MakeICT/MCP-Client/README.md

# MCP-Client
Clients for the Master Control Program

Code compiled using ESP-IDF v3.3. Installation instructions can be found here: https://docs.espressif.com/projects/esp-idf/en/stable/get-started/index.html#introduction
