MakeICT/MCP-Client/hardware/Reader 3.0.brd

## EAGLE design hardware/Reader 3.0.brd (2019-04-20)

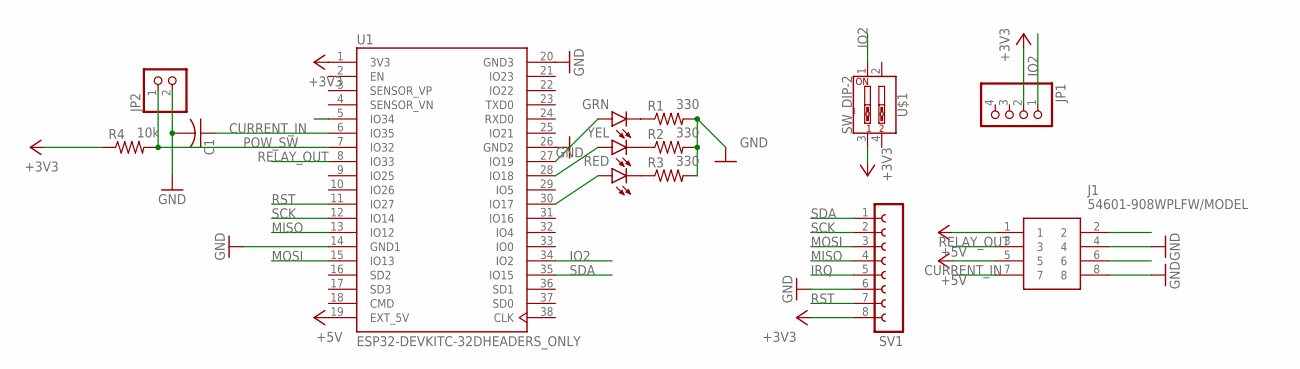
[picture p1: schematic Reader 3.0.sch]

Parts:
C1: C-US025-025X050; C025-025X050
GRN: LED5MM
J1: 54601-908WPLFW/MODEL; HDRV4W64P254_1X4_1016X508X838B
JP1: PINHD-1X4/90; 1X04/90
JP2: PINHD-1X2/90; 1X02/90
R1, R2, R3: 330; 0204/7
R4: 10k; 0204/7
RED: LED5MM
SV1: FE08-1; HDR_F_1X8
U1: ESP32-DEVKITC-32DHEADERS_ONLY; ESP32_DEVKITC_DIP
U$1: SW_DIP-2
YEL: LED5MM

Connections:
+3V3: JP1.2, R4.1, SV1.8, U1.1 (3V3), U$1.3
+5V: J1.1, J1.5, U1.19 (EXT_5V)
CURRENT_IN: C1.1, J1.7, U1.6 (IO35)
GND: C1.2, J1.4, J1.8, JP2.2, R1.2, R2.2, R3.2, SV1.6, U1.14 (GND1), U1.20 (GND3), U1.26 (GND2)
IO2: JP1.1, U1.34 (IO2), U$1.1
IRQ: SV1.5
MISO: SV1.4, U1.13 (IO12)
MOSI: SV1.3, U1.15 (IO13)
unnamed: RED.A, U1.30 (IO17)
unnamed: U1.28 (IO18), YEL.A
unnamed: GRN.A, U1.27 (IO19)
unnamed: GRN.K (C), R1.1
unnamed: R2.1, YEL.K (C)
unnamed: R3.1, RED.K (C)
POW_SW: JP2.1, R4.2, U1.7 (IO32)
RELAY_OUT: J1.3, U1.8 (IO33)
RST: SV1.7, U1.11 (IO27)
SCK: SV1.2, U1.12 (IO14)
SDA: SV1.1, U1.35 (IO15)

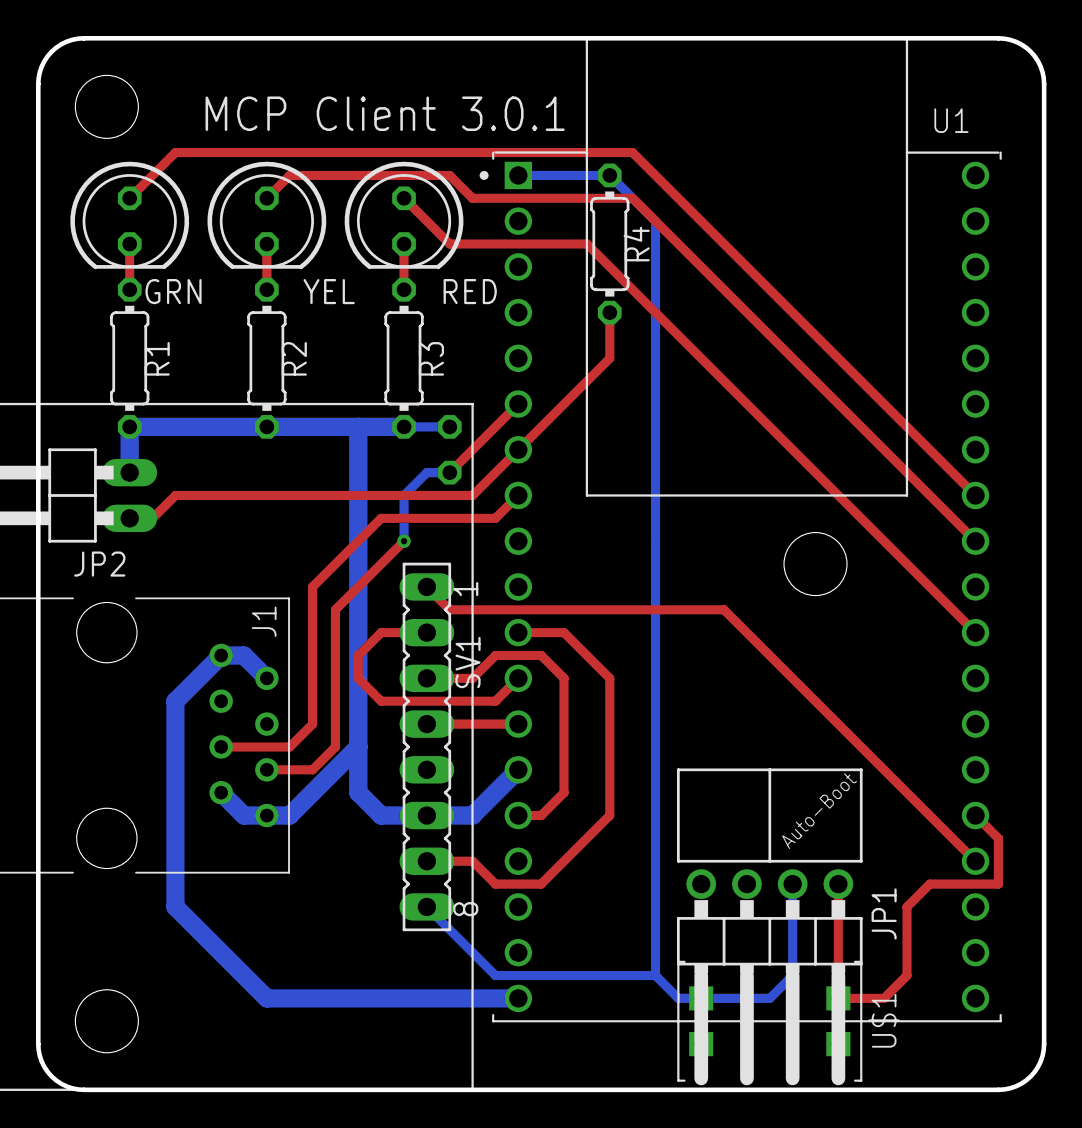
[picture p2: board Reader 3.0.brd from above]

Board: 2 copper layers, 55.9 x 58.4 mm, 14 parts (1 on the bottom side), 18 nets.
