MakeICT/MCP-Client/hardware/Power Module 3.0.brd

## EAGLE design hardware/Power Module 3.0.brd (2019-04-13)

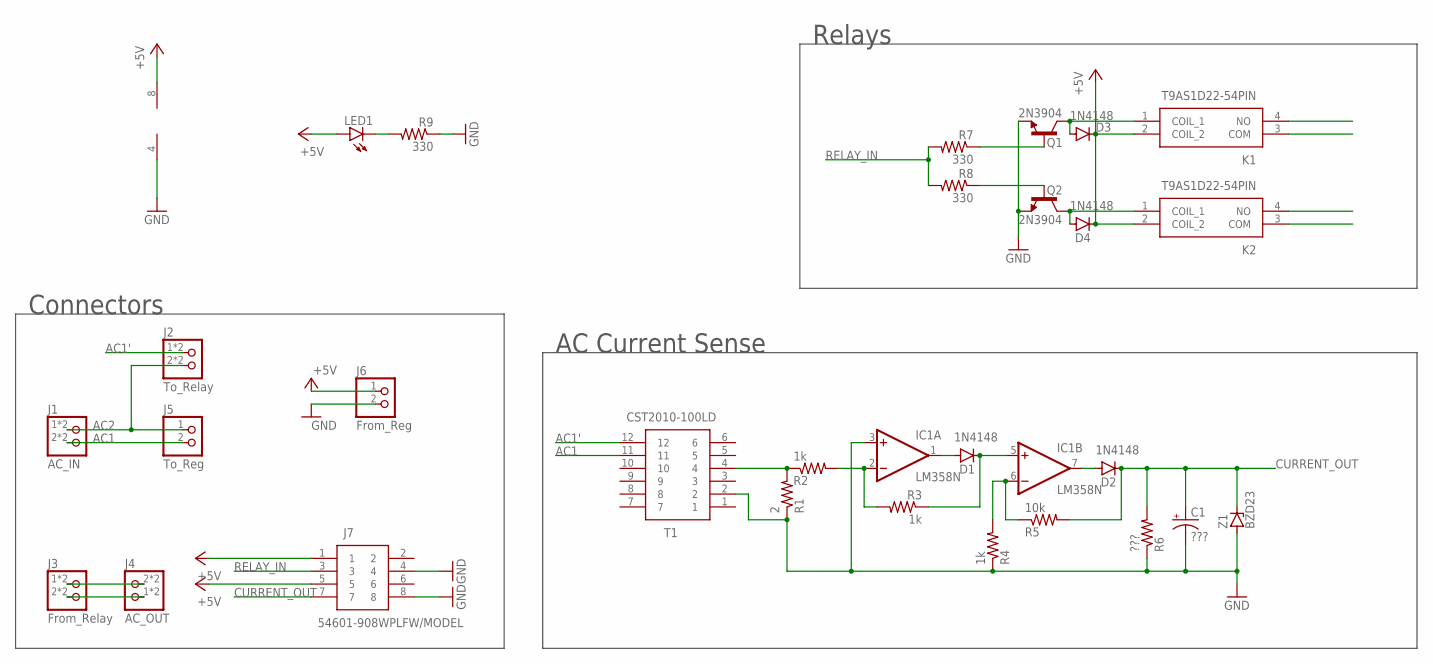
[picture p3: schematic Power Module 3.0.sch]

Parts:
C1: ???; E1,8-4
D1, D2, D3, D4: 1N4148; DO35-7
IC1: LM358N; DIL08
J1: AC_IN; HDRRA4W64P762_2X2_1016X254X556B
J2: To_Relay; HDRRA4W64P762_2X2_1016X254X556B
J3: From_Relay; HDRRA4W64P762_2X2_1016X254X556B
J4: AC_OUT; HDRRA4W64P762_2X2_1016X254X556B
J5: To_Reg; HDRV2W64P792_1X2_1016X508X838B
J6: From_Reg; HDRV2W165P396_1X2_1016X508X838B
J7: 54601-908WPLFW/MODEL; HDRV4W64P254_1X4_1016X508X838B
K1, K2: T9AS1D22-54PIN; T9AS5D1212313932103-2
LED1: LED5MM
Q1, Q2: 2N3904; TO92
R1: 2; 0204/7
R2, R3, R4: 1k; 0204/7
R5: 10k; 0204/7
R6: ???; 0204/7
R7, R8, R9: 330; 0204/7
T1: CST2010-100LD; CST2010100LD
Z1: BZD23; SOD81

Connections:
+5V: D3.C, D4.C, IC1.8 (V+), J6.1, J7.1, J7.5, K1.2 (COIL_2), K2.2 (COIL_2), LED1.A
AC1: J1.2, J1.3 (2), J5.2, T1.11
AC1': J2.1, J2.4 (1), T1.12
AC2: J1.1, J1.4 (1), J2.2, J2.3 (2), J5.1
CURRENT_OUT: C1.+, D2.C, J7.7, R5.2, R6.2, Z1.C
GND: C1.-, IC1.3 (+IN), IC1.4 (V-), J6.2, J7.4, J7.8, Q1.3 (E), Q2.3 (E), R1.1, R4.1, R6.1, R9.1, T1.2, Z1.A
unnamed: J3.1, J3.4 (1), J4.2, J4.3 (2)
unnamed: R1.2, R2.1, T1.4
unnamed: D1.A, IC1.1 (OUT)
unnamed: J3.2, J3.3 (2), J4.1, J4.4 (1)
unnamed: D1.C, IC1.5 (+IN), R3.1
unnamed: IC1.6 (-IN), R4.2, R5.1
unnamed: IC1.2 (-IN), R2.2, R3.2
unnamed: D3.A, K1.1 (COIL_1), Q1.1 (C)
unnamed: D2.A, IC1.7 (OUT)
unnamed: D4.A, K2.1 (COIL_1), Q2.1 (C)
unnamed: Q1.2 (B), R7.1
unnamed: Q2.2 (B), R8.1
unnamed: LED1.K (C), R9.2
RELAY_IN: J7.3, R7.2, R8.2

Notes on the sheet:
AC Current Sense
Relays
Connectors

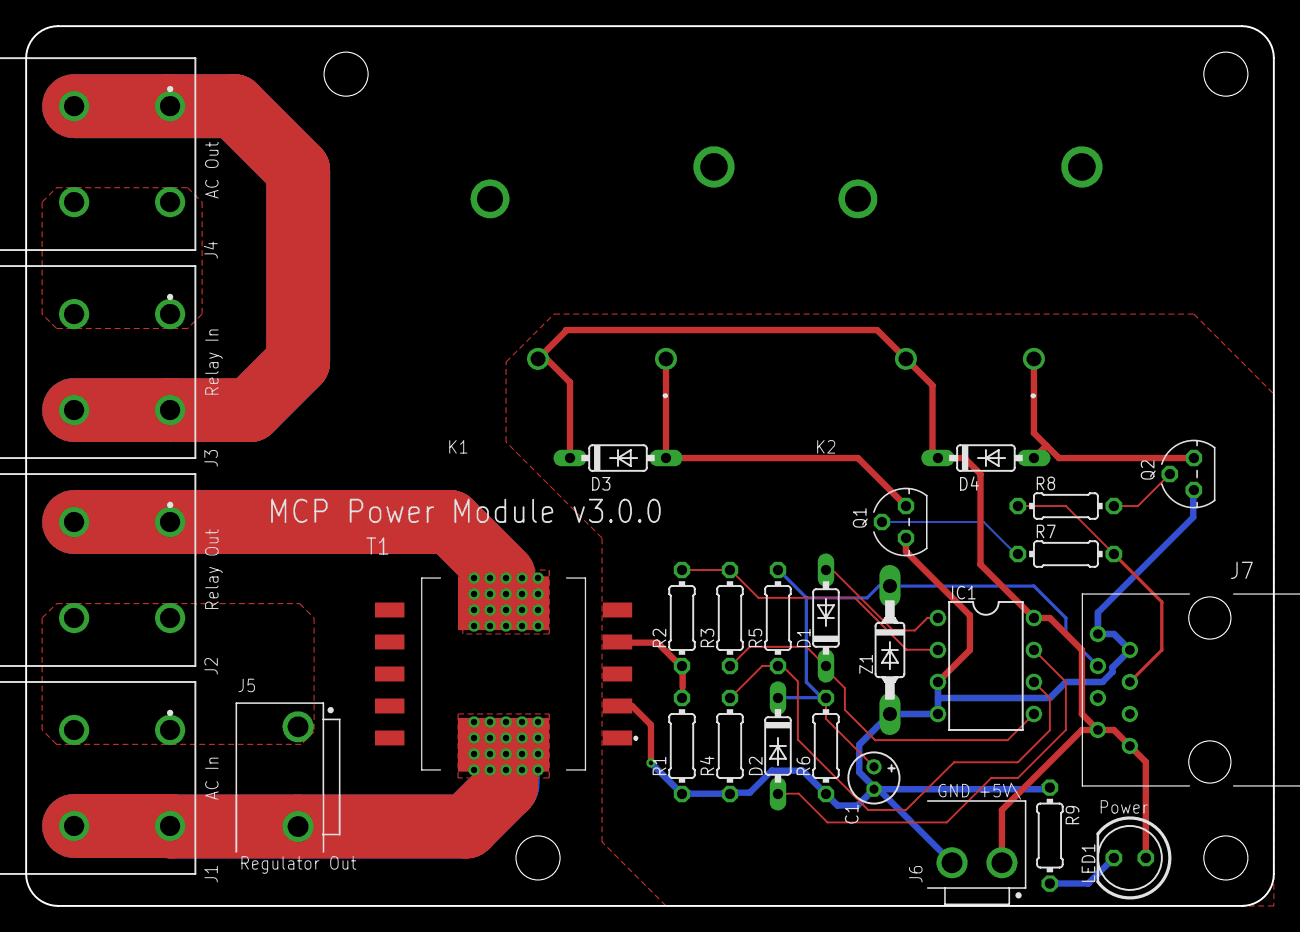
[picture p4: board Power Module 3.0.brd from above]

Board: 2 copper layers, 99.1 x 69.8 mm, 29 parts (0 on the bottom side), 20 nets.
