MakeICT/MCP-Client/hardware/reader-and-latch-client-V2016-4-19.brd

## EAGLE design hardware/reader-and-latch-client-V2016-4-19.brd (2016-07-06)

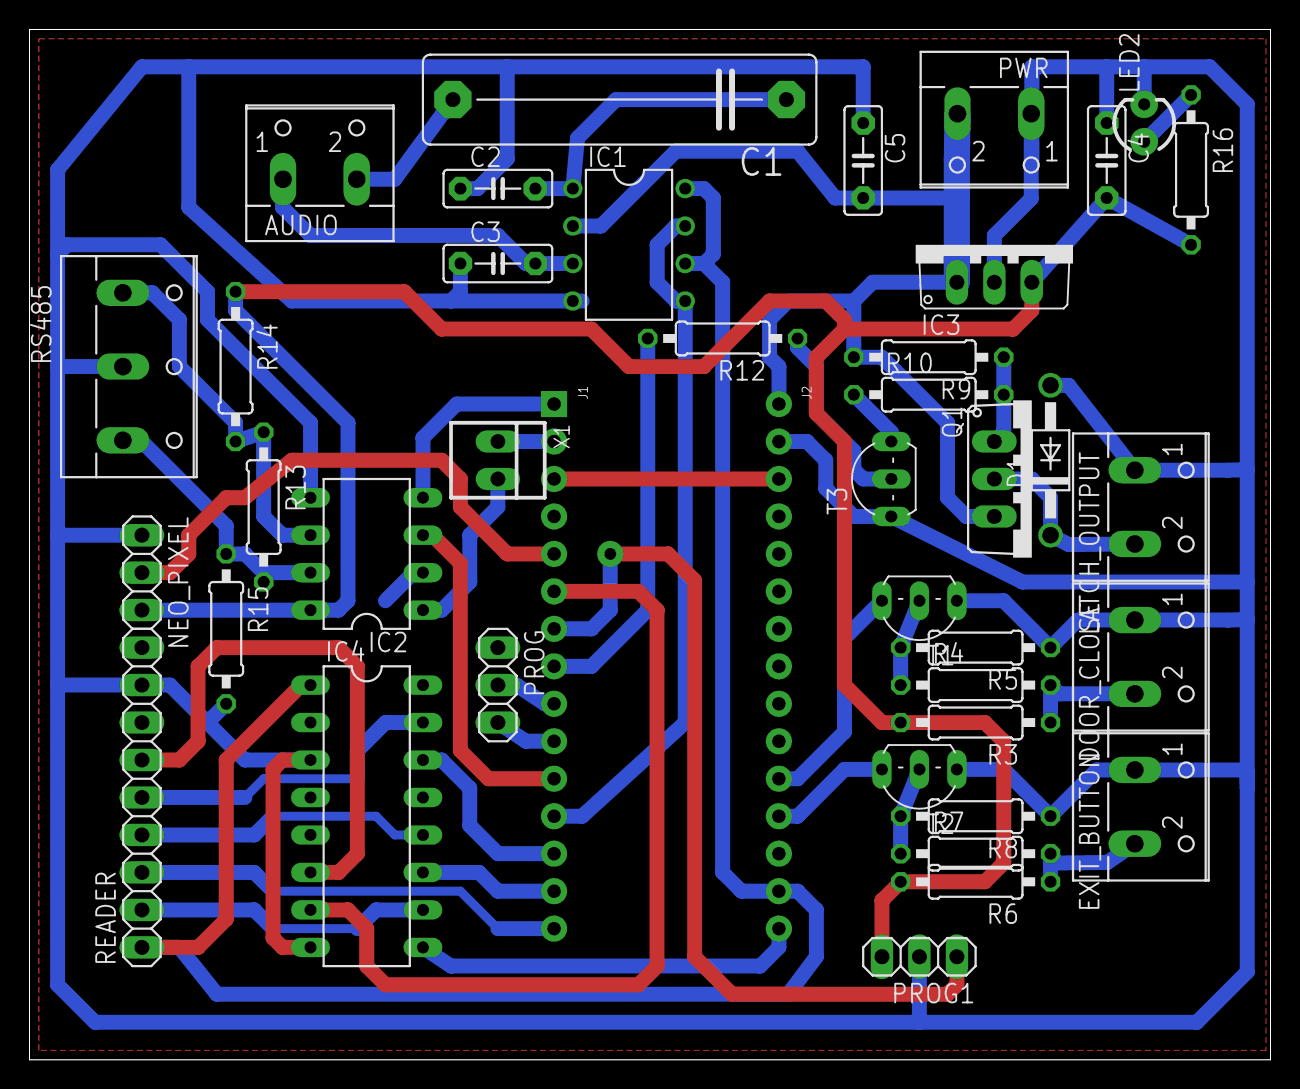
[picture p5: board reader-and-latch-client-V2016-4-19.brd from above]

Board: 2 copper layers, 84.1 x 69.8 mm, 41 parts (0 on the bottom side), 40 nets.

Parts:
AUDIO: W237-102
C1: 10uf; C22.5B6
C2, C3, C4, C5: .1uf; C5B2.5
D1: 1N4004; DO41-10
DOOR_CLOSE: W237-102
EXIT_BUTTON: W237-102
IC1: L272M; DIL08
IC2: MAX3468EPA; DIL08
IC3: MC78M05ABT; TO220V
IC4: 4050N; DIL16
J1: HEAD15-NOSS
J2: HEAD15-NOSS-1
LATCH_OUTPUT: W237-102
LED2: LED3MM
NEO_PIXEL: 1X03
PROG, PROG1: 1X03
PWR: W237-102
Q1: TIP42C; TO220AV
R3, R4, R5, R6, R7, R8, R9: 10K; 0207/10
R10: 2k; 0207/10
R12: 0207/10
R13: 100; 0207/10
R14, R15: 20K; 0207/10
R16: 330; 0207/10
READER: 1X09
RS485: W237-103
T1, T2, T3: TO92-EBC
X1: 22-23-2021

Connections:
3V3: IC1.6, IC1.8, IC4.1, J2.14, READER.1
+5V: C4.2, IC2.8, IC3.3, NEO_PIXEL.3, PROG1.3, R3.2, R6.2, R14.1, R16.2
A0: J2.12, T2.C
A1: J2.11, T1.C
COM: C2.1, C3.1, C4.1, C5.1, D1.A, DOOR_CLOSE.1, EXIT_BUTTON.1, IC1.4, IC2.2, IC2.5, IC3.2, IC4.3, IC4.8, J1.4, J2.2, LATCH_OUTPUT.1, LED2.K, NEO_PIXEL.1, PROG.1, PROG1.2, PWR.1, R5.1, R8.1, R15.2, READER.8, RS485.2, T1.E, T2.E, T3.E
D2: J1.5, NEO_PIXEL.2
D3: IC4.7, J1.6
D4: J1.7, PROG1.1
D6: J1.2, X1.1
D7: IC2.4, J1.1
D8: IC2.3, J1.11
D9: IC1.5, IC1.7, J1.12
D10: IC4.14, J1.13
D11/MOSI: IC4.11, J1.14
D12/MISO: J1.15, READER.3
D13: J1.8, R12.2
unnamed: D1.C, LATCH_OUTPUT.2, Q1.C
unnamed: R12.1, T3.B
unnamed: IC4.6, READER.6
unnamed: IC2.7, R13.2, R15.1, RS485.3
unnamed: IC2.6, R13.1, R14.2, RS485.1
unnamed: J1.9, PROG.2
unnamed: C1.1, C2.2, IC1.1
unnamed: AUDIO.2, C1.2
unnamed: AUDIO.1, C3.2, IC1.3
unnamed: LED2.A, R16.1
unnamed: R4.1, R5.2, T1.B
unnamed: DOOR_CLOSE.2, R3.1, R4.2
unnamed: R7.1, R8.2, T2.B
unnamed: EXIT_BUTTON.2, R6.1, R7.2
unnamed: R10.1, T3.C
unnamed: Q1.B, R9.1, R10.2
unnamed: IC4.10, READER.2
unnamed: IC4.12, READER.4
unnamed: IC4.15, READER.5
unnamed: J1.10, PROG.3
unnamed: IC4.9, J2.15
unnamed: IC2.1, X1.2
RESET: J1.3, J2.3
VIN: C5.2, IC1.2, IC3.1, J2.1, PWR.2, Q1.E, R9.2
