MakeICT/MCP-Client/(threads)

Thread 7 (2021-01-18):

GPIO 36 and 39 constantly trigger interrupts

Rowbotronics, 2021-01-18:
https://github.com/espressif/esp-idf/issues/1096

Thread 8 (2021-01-20):

Alarm arm button

Rowbotronics, 2021-01-20:
Need to re-add the button that arms the alarm system. Ideally this would be via a dedicated module connected to the alarmsystem that handles all arm/disarm requests for MCP.

Arming via Keyswitch
- all zones (doors and motions) are immediately armed.
- the last discussed plan was to have a button push in MCP have a delay of maybe a minute before arming via keyswitch.
- MCP would wait up to 3 minutes, check system is armed and if not attempt arming again.
- MCP would wait another duration, check system and attemp another re-arm
- MCp would check a final time and send notification at arm failed.
