MakeICT/MCP-Client/(commit log)

2015-10-08 Add Tom's 9-2015 schematic
    [reader-and-latch-client-schematic.sch]
2015-10-08 Add Tom's 13-2015 schematic
    [reader-and-latch-client-schematic.sch]
2015-10-10 Update from 9-2015
    [reader-and-latch-client-schematic.sch]
2015-11-11 Fix bug rs485 module bug, delete workaround code
    [driver.ino]
2015-11-12 Reduce excess code -remove old test code -fix minor serial bug -clean up some formatting
    [driver.ino]
2015-11-15 Fix index rollover causing audio to repeat
    [driver.ino]
2015-11-17 Re-organize code -add function to send button / door states -add class for door strike -re-arrange serial code
2015-11-23 Remove SoftwareSerial dependency - move to hardware serial port - fix error in byte stuffing algorithm - modify serial test code
    [driver.ino]
2015-11-24 Modify audio code, fix serial bugs -restructure audio to take byte arrays -tunes can now be sent over network -bug preventing serial rx fixed
    [driver.ino]
2015-11-24 Fix audio and serial issues -fix bug causing packets to be processed twice -add more packet verification -fix wrong note being played sometimes
    [driver.ino]
2016-01-13 Update latch pin number
2016-01-25 Fix bug causing strike to stay at full power when unlocked indefinitely
2016-01-25 Fix serial bugs -packets were found invalid due to incorrectly pulling (fake) crc from packet -fixed sending NAK on packets not addressed to device -added more logging
    [driver.ino]
2016-01-27 Fix failure to go into WAIT_SEND after reading an NFC card
    [driver.ino]
2016-02-17 re-add driver.ino
2016-03-02 Fix crash caused by verifying CRC
    [driver.ino]
2016-03-09 Add handling of deny message, fix minor logging bugs
    [driver.ino]
2016-03-09 Fix resend interval, remove old code
    [driver.ino]
2016-03-23 add missing break statement
    [driver.ino]
2016-03-26 fix bug sending UIDs of less than 7 bytes
    [driver.ino]
2016-03-30 Update pin assignments, add serial LCD code
2016-04-02 Detect NFC reader failures, improve logging
    [driver.ino]
2016-05-01 fix serial boo-boos - don't wait for response on ACKs and resend the last non-ACK packet. Oops. - properly increment transaction ID when sending new packets
    [driver.ino]
2016-05-12 Fix serial issues, add conditionals for different modules -fix transaction ID not incrementing properly on received packets -improve collision detection and avoidance
    [driver.ino]
2016-07-06 Fix some corner cases -re-lock door if program crashes -change start tune to 2 beeps -update lights, lock , and speaker even if uninitialized -add longer uid resend interval when the same id is scann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
    [driver.ino]
2016-07-07 Fix same ID resend timeout
    [driver.ino]
2016-07-14 Fix client handling of broadcast packets
    [driver.ino]
2016-07-16 Add makefile for driver source, restructure source and libs
2016-07-16 Re-organize and update board layout files
    [Door_Client.brd, Door_Client.sch, makeict-security-server-V2016-3-29.brd, makeict-security-server-V2016-3-29.sch, reader-and-latch-client-schematic.sch]
2016-07-19 Fix handling of client address initialization
    [driver.ino]
2016-07-19 Fix char* warning in lcd library
    [driver.ino]
2016-07-21 Move files back for Arduino IDE compatibility :(
2016-07-23 Parts List as of July 2016
    Through together a rough parts list. Things are a little more costy that I had thught.... Tom
    [DoorProjectParts.ods]
2016-07-23 Eagle PC board files and mill files
    Current board files as of July 2016 Tom
    [reader-and-latch-client-V2016-7-5.brd, reader-and-latch-client-V2016-7-5.sch]
2016-07-23 Fix failure to use correct client address in response packets.
    [driver.ino]
2016-07-27 Add watchdog timer to prevent client freezes
    [driver.ino]
2016-07-29 Add hard reset for NFC reader after 2 failed attempts to restart it -also initialize some variable and clean some formatting
    [driver.ino]
2016-07-29 Add forced reset if reader cannot be recovered
    [driver.ino]
2016-08-01 Modify reader failure detection and recovery
    [driver.ino]
2016-08-01 Improve reader failure reset logic
    [driver.ino]
2016-08-02 Read doorState at beginning to prevent false updates
    [driver.ino]
2016-08-03 Clean up some config errors, use EEPROM config for lights and sounds
    [driver.ino]
2016-08-03 Fix config save/load error, add configs for wait and error lights
    [driver.ino]
2016-08-04 re-add mistakenly removed light sequence when unlocking
    [driver.ino]
2016-08-04 Fix config save/load to get all of the proper values -load same address as save (duh) -fix saving of start tune -modify audio to work with new config
    [driver.ino]
2016-08-04 Move board milling files to proper folder
    [reader-and-latch-client-V2016-7-5.brd, reader-and-latch-client-V2016-7-5.sch]
2016-08-07 fix pin assignment for PN532
    [driver.ino]
2016-08-24 tweak NFC read error detection
    [driver.ino]
2016-12-07 change pin assignments
2017-01-01 make latch work when no door switch is present
2017-01-11 fix some whitespace, minor re-formatting
    [driver.ino]
2017-01-16 update .gitignore, add new board files, put gcode files in new folder
    [Mini_Door_Client.brd, Mini_Door_Client.sch, Portable_Client-2.brd, Portable_Client-2.sch]
2017-01-19 New client board V0.1
    [Mini_Door_Client.brd, Portable_Client-2.brd, Portable_Client-2.sch]
2017-01-31 Move pin definitions to definitions.h, fix doorbell input declaration
    [driver.ino]
2017-02-01 Redefine pnis for new board layout
2017-02-01 modify platformio.ini for new board layout
2017-02-01 fix a few board errors -MOSI and MISO swapped on LCD and SPI headers -change esp8266 capacitor to surface mount
    [Portable_Client-2.brd, Portable_Client-2.sch]
2017-02-07 Fix DRC errors in wifi client board.
    [Portable_Client-2.brd]
2017-02-08 re-assign pins for original board layout
2017-02-08 revert clock speed to 16mhz for original board layout
2017-02-08 actually revert pin assignments and clock speed this time
2017-02-08 fix pin name
2017-02-09 change mini light board outline to mill layer
    [Door_Client.brd, Mini_Door_Client.brd]
2017-02-26 fix wdt boot loop
    [driver.ino]
2018-08-10 Add files for esp32 client
2018-08-15 switch from esp_tls library to esp_http_client library, working authentication and user get function
2018-08-16 re-arrange http calls, add led class, start adding json parser
2018-08-20 fix bug in fetching HTTP responses
    [wifi_client_main.cpp]
2018-08-23 fix logging issues, change nfcID to lowercase hex
    [wifi_client_main.cpp]
2019-02-19 add power switch, bring function in line with current raspberry pi based client w
2019-03-05 remove old board files
    [DoorProjectParts.ods, Door_Client.brd, Door_Client.sch, Mini_Door_Client.brd, Mini_Door_Client.sch, Portable_Client-2.brd, Portable_Client-2.sch]
2019-03-05 add new eagle project filesy
    [Reader 3.0.brd, Reader 3.0.sch]
2019-03-05 add rj45 jack to board
    [Reader 3.0.brd, Reader 3.0.sch]
2019-03-05 Assign jack pins
    [Reader 3.0.brd, Reader 3.0.sch]
2019-03-05 change unlock pin
2019-03-05 re-order the power off sequence so green light doesn't stay on if network is slow
    [wifi_client_main.cpp]
2019-03-05 add current sense input
    [Reader 3.0.brd, Reader 3.0.sch]
2019-03-12 Slight adjustments to board layout, add pullup resistor
    [Reader 3.0.brd, Reader 3.0.sch]
2019-03-20 switch red and green LED pins in software
2019-03-20 change LED names in circuit layout
    [Reader 3.0.brd, Reader 3.0.sch]
2019-03-20 adjust LED resistor positions
    [Reader 3.0.brd]
2019-04-06 Add first draft of power module 3.0.0
    [Control Box 3.0.brd, Control Box 3.0.sch]
2019-04-06 Replace LM324 with LM358, clean up component names, silkscreen layout, and some routing
    [Control Box 3.0.brd, Control Box 3.0.sch]
2019-04-06 fix ground pours on relay module
    [Control Box 3.0.brd]
2019-04-06 add power indication led to relay module
    [Control Box 3.0.brd, Control Box 3.0.sch]
2019-04-07 fix VH connectors on relay module
    [Control Box 3.0.brd, Control Box 3.0.sch]
2019-04-13 Minor Power Module layout tweaks, rename files
    [Power Module 3.0.brd, Power Module 3.0.sch]
2019-04-14 fix incompatible SPI flag setting for ESP-IDF 3.1.3
2019-04-19 add current detection shutoff
2019-04-20 fix current input wiring * ADC2 on IO25 is not usable when WiFi is active. * switch to ADC1 on IO32 * add capacitor to input * remove pullup resistor
    [Reader 3.0.brd, Reader 3.0.sch]
2019-05-04 add config settings for client tag and current timeout
2019-06-02 Tweak reader schematic
    [Reader 3.0.sch]
2019-07-24 re-authenticate if API call fails
    [wifi_client_main.cpp]
2020-04-08 comment out some API calls that don't currently apply to the new library
2020-07-19 configure project for platformio
    [partitions_mcpsingle.csv]
2021-01-15 add api call to de-authorize when power is lost
